kuwala/MirrorWallMicro/processing/MainInterface/MainInterface.pde

import ch.bildspur.realsense.*;
import processing.serial.*;

RealSenseCamera camera = new RealSenseCamera(this);
int camWidth = 640;
int camHeight = 480;




Serial sPort;
int rows = 24;
int cols = 24;
int numPixels = cols * rows;
int squareSize = 32; // 32 pixels

// pixel grid stores pixel values to send over serial
int[] pixelGrid = new int[numPixels];
int[] pixelGridLast = new int[numPixels];
int[] targetValuesLast = new int[numPixels];
// int[][] pixelGrid2D = new int[rows][cols]; // y,x
int[] pixelTemps = new int[numPixels];
int[] pixelStates = new int[numPixels]; // 0 - idle, 1 - overheated
int triggerRateTemp = 64; // adds 32 temp every time a pixel value is changed
int cooldownRateTemp = 7; // cools down 8 temp every frame
int pixelTempMax = 32*12 - 8*12; // about 12 frames of changes to overheat

boolean buttonColorToggle = false;
boolean noiseClippingToggle = false;
boolean cooldownToggle = true;

int appState = 0; // 0 draw pixels mode, 1 test pattern loop
String testLoopText = "test loop OFF";
String cameraButtonText = "Camera OFF";
String noiseButtonText = "IR shadow FG";
String cooldownButtonText = "Cooldowns ON";
int testLoopIndex = 0;

// This can turn on or off debugging info from microcontroller over serial
boolean printSerialFromMicro = true;
void setup() {
  pixelDensity(2);
  size(1600,900);

  camera.enableDepthStream(640,480);
  camera.enableColorStream();
  camera.enableColorizer();
  camera.enableAlign(); // Not sure if it does anything
  camera.start();
  
  noStroke();
  
  // show serial devices
  printArray(Serial.list());
  
  //connect to a Serial port
  String portName = Serial.list()[0];
  print("\n\nConnecting to serial on: ");
  println(portName);
  sPort = new Serial(this, portName, 115200);
  
}

void draw() {
  
  background(0);
  fill(127);
  for(int i = 0; i < numPixels; i ++) {
    if ( pixelGrid[i] == 0 ) {
      fill(127);
    } else if ( pixelGrid[i] == 2 ) {
      fill(255);
    }
    int x = (i % cols) * 32;
    int y = (i /cols) * 32;
    rect(x,y, 24, 24);
    //noStroke();
    // draw pixel temp state
    if(cooldownToggle) {
      if(pixelStates[i] == 1) {
        fill(255,0,0);
        rect(x, y, 8, 8);
      }
    }

}
  if(buttonColorToggle) {
    fill(170);
  } else {
    fill(200);
  }
  // The buttons!
  rect(32, 32*(rows+1) - 16, 96, 32); // send serial button
  rect(32 + (32+64+32), 32*(rows+1) - 16, 96, 32); // test pattern button
  rect(32 + (32+64+32)*2, 32*(rows+1) - 16, 96, 32); // camera button
  rect(32 + (32+64+32 + 100)*2, 32*(rows+1) - 16, 96, 32); // noise button
  rect(32 + (32+64+32 + 200)*2, 32*(rows+1) - 16, 96, 32); // cooldown button
  fill(64);
  text("send pixels",32+ 8, 32 * (rows+1) );
  text(testLoopText, (32+64+32) + 32+ 8, 32 * (rows+1) );
  text(cameraButtonText, (32+64+32)*2 + 32+ 8, 32 * (rows+1) );
  text(noiseButtonText, (32+64+32+ 100)*2 + 32+ 8, 32 * (rows+1) );
  text(cooldownButtonText, (32+64+32+200)*2 + 32+ 8, 32 * (rows+1) );
  if (appState == 0) { // draw mode
    // serial is sent when button press is detected
  } else if(appState == 1) { // test pattern

    // flip a pixel
    if(pixelGrid[testLoopIndex] == 0) {
      pixelGrid[testLoopIndex] = 2;
    } else {
      pixelGrid[testLoopIndex] = 0;
    }
    // send all pixels over serial
    sendPixelsOverSerial();
    
    
    // send all pixels over serial
    // for(int i = 0; i < numPixels; i ++) {
    //   if(i%16 == 0) {
    //     sPort.write(char(floor(i/16)));
    //   }
    //   if(pixelGrid[i] == 0) {
    //     sPort.write("1");
    //   } else {
    //     sPort.write("2");
    //   }
    // }
    // sPort.write(char(255));
    // for(int i = 0; i < 16; i ++ ) {
    //   sPort.write(char(0));
    // }


    if(testLoopIndex >= numPixels-1) {
      testLoopIndex = 0;
    } else {
      testLoopIndex++;
    }

  } else if (appState == 2) {
    // run camera
    doCameraUpdates();
    sendPixelsOverSerial();
    
    

  }
}

void doCameraUpdates()
{
  //background(22);
  // read frames
  camera.readFrames();
  // draw camera feed
    push();
    scale(-1,1);
    blendMode(BLEND);
    image(camera.getColorImage(), -1500, 0);
    blendMode(MULTIPLY);
    image(camera.getDepthImage(), -1500, 0);
    blendMode(BLEND);
    pop();
  
  // read depth buffer
  short[][] data = camera.getDepthData(); //480x640
  //for(int i = 0; i < 480; i++) {
  //  for(int j = 0;j < 640; j++) {
  //    data[i][j] = 3000; 
  //  }
  //}
  noFill();
  // remove for DRAW // strokeWeight(1.0);
  // use it to display circles
  for (int y = 0; y < camHeight; y += 20) {
    for (int x = 0; x < camWidth-160; x += 20) {
      //if(y < height && width < width) {
      // get intensity
      // cropping the left most 40 pixels out
      
      int intensity = data[y][x+40];
      if(y==0) {
        intensity = data[y+10][x+40];
      }
      // map intensity (values between 0-65536)
      //float d = map(intensity, 0, 3000, 20, 0);
      if(noiseClippingToggle) {
        if (intensity< 1) {
          intensity = 3000; 
        }
      }
      float c = map(intensity, 0, 3000, 255, 0);
      //d = constrain(d, 0, 16);
      c = constrain(c, 0, 255); // for 0-3000 its about 12 pixels per value increment
      // Average surounding pixels
      // int sumIntensity = 0;
      // int averageIntensity = 0;
      // for(int i = 0; i < 20; i ++) {
      //     for(int j = 0; j < 20; j++) {
      //      sumIntensity = sumIntensity + data[y+i][x+j];
      //   }
      // }
      // averageIntensity = sumIntensity / (20*20);
      //print("average Intensity: "); println(averageIntensity);
      //print("regular Intensity: "); println(intensity);
      //print("sum intensity: "); println(sumIntensity);
        
      //float d = map(averageIntensity, 0, 3000, 20, 0);
      float d = map(intensity, 0, 3000, 20, 0);
      d = constrain(d, 0, 16);
      
      // reversing the X of the index to flip the pixels
      // so the camera looks like a mirror
      int pixelIndex = (y/20)*cols + (cols-((x/20)+1));
     
      pixelGridLast[pixelIndex] = pixelGrid[pixelIndex];
      int targetPixelValue = 2;
      if (d > 9) {
        targetPixelValue = 2;
      } else  {
        targetPixelValue = 0;
      }
      if(cooldownToggle) {
        if (targetPixelValue != pixelGridLast[pixelIndex]) {
          if(pixelStates[pixelIndex] == 0) { // idle 
            // pixelTemps[pixelIndex] += triggerRateTemp;
            // if(pixelTemps[pixelIndex] > pixelTempMax) {
            //   pixelTemps[pixelIndex] = pixelTempMax;
            //   pixelStates[pixelIndex] = 1;
            // }
            pixelGrid[pixelIndex] = targetPixelValue;
          } 
        }
        if(targetValuesLast[pixelIndex] != targetPixelValue) {
          pixelTemps[pixelIndex] += triggerRateTemp;
          if(pixelTemps[pixelIndex] > pixelTempMax) {
            pixelTemps[pixelIndex] = pixelTempMax;
            pixelStates[pixelIndex] = 1;
          }
        }
        targetValuesLast[pixelIndex] = targetPixelValue;
        pixelTemps[pixelIndex] -= cooldownRateTemp;
        if(pixelTemps[pixelIndex] <0) {
          pixelTemps[pixelIndex] = 0;
          pixelStates[pixelIndex] = 0;
        }
      } else {
        pixelGrid[pixelIndex] = targetPixelValue;
      } // end cooldownToggle


      
      // if (d > 9) {
      //   stroke(c, 255, 255);
      //  //REMOVE TO DRAW// circle(x, y, d);
      //   //print("y: ");
      //   //print(y); print(" x: "); println(x);
      //   //println((y/20)*cols + (x/20));

      //   // if pixel state is idle update
      //   // else ignore pixel change until it cools down

      //   // int index = (y/20)*cols + (x/20);
      //   if (pixelIndex < cols*rows) {
      //     if (pixelStates[pixelIndex] == 0) { // if idle
      //       if(pixelGrid[pixelIndex] == 0) { // if pixel changed
      //         // trigger changed temp up
      //         pixelTemps[pixelIndex] += triggerRateTemp;
      //         if(pixelTemps[pixelIndex] > pixelTempMax) {
      //           pixelStates[pixelIndex] = 1;// over heated
      //         }
      //         pixelGrid[pixelIndex] = 2;

      //       } else {
      //         pixelTemps[pixelIndex] -= cooldownRateTemp;
      //         if(pixelTemps[pixelIndex]<0) {
      //           pixelTemps[pixelIndex] = 0;
      //         }
      //         // pixelGrid[pixelIndex] stayed the same last frame
      //       }

      //     } else { // cooling down
      //       // can still raise temp so it does not oscilate between states
      //       // if(pixelTemps[pixelIndex] < pixelTempMax) {
      //       //   if(pixelGridLast[pixelIndex] != pixelGrid[pixelIndex]) {
      //       //     pixelTemps[pixelIndex] += triggerRateTemp;
      //       //   }
      //       // }
      //       pixelTemps[pixelIndex] -= cooldownRateTemp;
      //       if(pixelTemps[pixelIndex]<0) {
      //         pixelTemps[pixelIndex] = 0;
      //         pixelStates[pixelIndex] = 0; // done cooling down
      //       }

      //     }
      //   }
          
      // } else { // deapth is pixel that is off
      //   // int index = (y/20)*cols + (x/20);
      //   if (pixelIndex < cols*rows) {
      //     if(pixelStates[pixelIndex] == 0) { // if idle
      //       if(pixelGrid[pixelIndex] == 2) { // if pixel changed
      //         pixelTemps[pixelIndex] += triggerRateTemp;
      //         if(pixelTemps[pixelIndex] > pixelTempMax) {
      //           pixelStates[pixelIndex] = 1;// over heated
      //         }
      //         pixelGrid[pixelIndex] = 0;
      //       }

      //     } else { // cooling down
      //       pixelTemps[pixelIndex] -= cooldownRateTemp;
      //       if(pixelTemps[pixelIndex]<0) {
      //         pixelTemps[pixelIndex] = 0;
      //         pixelStates[pixelIndex] = 0;
      //       }

      //     }
      //   }
      // }

     // } // something else
    }
  }
}



void sendPixelsOverSerial() {
    
  // send one section of 8x8 at a time
  int numOfSections = numPixels / 64;
  int colsPerBoard = 8;
  int sectionOffset = 0; // the start of pixel 0 for each section
  for(int sectionIndex = 0; sectionIndex < numOfSections; sectionIndex++) {
    int boardOffset = 0;
    // send serial header : each section has 4 boards
    for (int boardNum = 0; boardNum < 4; boardNum++) {

      // 4 boards per section
      sPort.write(char(sectionIndex*4 + boardNum));
      // for 2 rows of pixels per board
      for (int currentRow = 0; currentRow < 2; currentRow ++) {
        // read 8 pixels (colsPerBoard)
        for(int i = 0; i < colsPerBoard; i ++) {
          int currentPixel = sectionOffset + boardOffset + currentRow * cols + i; // (cols = 24);
          if(pixelGrid[currentPixel] == 0) {
            sPort.write("1");
          } else {
            sPort.write("3");
          }
        }
      }
      boardOffset += cols*2; // to get next board in the section
    }
    sectionOffset += colsPerBoard;
    if(sectionIndex == 2 || sectionIndex == 5) {
      sectionOffset += 64*3 - colsPerBoard*3;
    }
  }

  // old method 
  // for(int i = 0; i < numPixels; i ++) {
  //   if(i%16 == 0) {
  //     sPort.write(char(floor(i/16)));
  //   }
  //   if(pixelGrid[i] == 0) {
  //     sPort.write("1");
  //   } else {
  //     sPort.write("2");
  //   }
  // }
  sPort.write(char(255));
  for(int i = 0; i < 16; i ++ ) {
    sPort.write(char(0));
  }

}

void mouseReleased() {
  // find rect the mouse clicked on
  int col = mouseX / squareSize;
  int row = mouseY / squareSize;
  
  if( col < cols && row < rows) {
    
    int i = row * cols + col;
    if (pixelGrid[i] == 0) {
      pixelGrid[i] = 2;
    } else {
      pixelGrid[i] = 0;
    }
  }
  // check if send serial button was clicked then send serial
  if( mouseX > 32 && mouseX < 32+96 && mouseY > (32*(rows+1) - 16) && mouseY < (32*(rows+1) +16)) {
    buttonColorToggle = !buttonColorToggle;
    sendPixelsOverSerial();
  }
  // decode the first 8 pixels
  // jump position to next 8 pixels 
  
  // check if test loop is pressed
  if( mouseX > 32+(32+96) && mouseX < 32+96 + (32 +96) && mouseY > (32*(rows+1) - 16) && mouseY < (32*(rows+1) +16)) {
    if(appState != 1) {
      // reset grid
      // set test loop index = 0
      // update state
      for(int i = 0; i < numPixels; i ++) {
        pixelGrid[i] = 0;
      }
      testLoopIndex = 0;
      appState = 1;
      testLoopText = "testLoop ON";
    } else {
      testLoopText = "testLoop OFF";
      appState = 0;
    }

    buttonColorToggle = !buttonColorToggle;
  }
  if( mouseX > 32+(32+96)*2 && mouseX < 32+96 + (32+96)*2 && mouseY > (32*(rows+1) - 16) && mouseY < (32*(rows+1) +16)) {
    if(appState != 2) {
        appState = 2;
        cameraButtonText = "Camera ON";
    } else {
        appState = 0;
        cameraButtonText = "Camera OFF";
    }
    buttonColorToggle = !buttonColorToggle;

  }
  if( mouseX > 32+(32+96+ 100)*2 && mouseX < 32+96 + (32+96 + 100)*2 && mouseY > (32*(rows+1) - 16) && mouseY < (32*(rows+1) +16)) {
    noiseClippingToggle = !noiseClippingToggle;
    if(noiseClippingToggle) {
        noiseButtonText = "IR shadow BG";
    } else {
        noiseButtonText = "IR shadow FG";
    }
  }
  if( mouseX > 32+(32+96 + 200)*2 && mouseX < 32+96 + (32+96 + 200)*2 && mouseY > (32*(rows+1) - 16) && mouseY < (32*(rows+1) +16)) {
    cooldownToggle = !cooldownToggle;
    if(cooldownToggle) {
        cooldownButtonText = "coolDowns ON";
    } else {
        cooldownButtonText = "coolDowns OFF";
    }
  }
  
}


void serialEvent(Serial sPort) {
  if(printSerialFromMicro) {
    int inByte = sPort.read();
    print((char)inByte);
  }
}
