kuwala/MirrorWallMicro/(commit log)

2025-09-29 works with 4 servos and processing ui
2025-09-30 added console printing from micro in processing
2025-10-20 about to switch to teensy as main microcontroller
2025-10-23 fixes for it to work on pc
    [SerialAndRealSense.pde]
2025-10-23 send camera pixels
2025-10-23 camera sender works for third of the servos
2025-10-25 add noSmooth servo updates
2025-10-26 Added SERVONINTEY
2025-10-27 fixed pixelGridLast not being set, and added depth pixel averaging
    [SerialAndRealSense.pde, main.cpp]
2025-10-27 trying to flip img horizontally
    [SerialAndRealSense.pde]
2025-11-17 switched to uno, solution found for line on camera
2025-12-01 added toggle buttons for settings
2025-12-02 corrected pwm module mapping. main is release read.
    [main.cpp]
